boerge42/GPS-Clock-NTP-Server/(commit log)

2026-06-21 Pin-Belegungen, ein paar Experimente wg. PPS-Sync, Tool lis-ntp-server.py
2026-07-03 NTP-Server verfeinert; erstes Setzen der Zeit verbessert
